JosePaen/proyecto-electrico-vivienda-unifamiliar/xlsx/PE-VU_Proyecto_Electrico_Vivienda_Unifamiliar.xlsx

Sheet: Grado Electrificacion
Cómputo de Superficies
Ambiente / Local | Tipo de superficie | Largo (m) | Ancho (m) | Sup. Real (m2) | Coeficiente | Sup. Computable (m2)
Dormitorio | Cubierta |  |  | 23.49 | 1.00 | 23.49
Baño principal | Cubierta |  |  | 6.52 | 1.00 | 6.52 | Sup. Total | 114.325
Estar | Cubierta |  |  | 10.48 | 1.00 | 10.48
Comedor | Cubierta |  |  | 19.30 | 1.00 | 19.30
Cocina | Cubierta |  |  | 7.31 | 1.00 | 7.31
Lavadero | Cubierta |  |  | 2.63 | 1.00 | 2.63
Baño servicio / lav. | Cubierta |  |  | 2.63 | 1.00 | 2.63
Tender | Semicubierta |  |  | 3.33 | 0.50 | 1.67
Cochera | Semicubierta |  |  | 36.41 | 0.50 | 18.20
Quincho | Semicubierta |  |  | 44.19 | 0.50 | 22.09
Total |  |  |  | 156.29 |  | 114.32
Parámetro | Valor Obtenido
Sup. Cubierta | 72.36
Sup. Semicubierta | 41.96
Superficie total (m2) | 114.32
Grado de Electrificación | Medio
Cantidad Mínima de Circuitos | 3
Variantes | a): 2 IUG + 1 TUG b): 1 IUG + 2 TUG

Sheet: Circuitos
Agrupamiento de bocas y definición de circuitos
Indicador | Valor |  | Fase | Potencia Equilibrada (VA) | Potencia Asignada (VA) | Distribución (%) | Desbalance de Fase (%) | ,
Potencia total instalada (VA) | 25930.00 |  | R | 8214.33 | 8147.33 | 0.31 | 0.82% | IDEAL
Demanda prevista máxima prevista (DPMS) -VA- | 24643.00 |  | S | 8214.33 | 8433.33 | 0.33 | -2.67% | IDEAL
Fase más cargada | S |  | T | 8214.33 | 8062.33 | 0.31 | 1.85% | IDEAL
Fase menos cargada | T
Desbalance | 4.52% | ✔ Cumple recomendación AEA (<10%)
Estado | IDEAL
Diferencia (VA) | 371.00
Circuito | Destino / Ambiente | Uso | Categoría | Sigla AEA | Cant. Bocas | Potencia Unitaria (VA) | Potencia Total (VA) | Factor Simultaneidad (Fs) | Demanda Simultánea (VA) | Fase | Tablero Destino
C1 | Dormitorio, baño, pasillo | Iluminación | Uso General | IUG | 13 | 60 | 780 | 0.8 | 624 | R | 1
C2 | Cochera, acceso | Iluminación | Uso General | IUG | 5 | 60 | 300 | 0.8 | 240 | T | 1
C3 | Cocina, comedor, estar | Iluminación | Uso General | IUG | 10 | 150 | 1500 | 0.66 | 990 | R | 1
C4 | Lavadero, baño 2, tender, quincho | Iluminación | Uso General | IUG | 11 | 150 | 1650 | 0.66 | 1089 | T | 1
C5 | Dormitorio, baño, pasillo | Tomacorrientes | Uso General | TUG | 7 | 2200 | 2200 | 1 | 2200 | S | 1
C6 | Cocina, comedor, estar | Tomacorrientes | Uso General | TUG | 7 | 2200 | 2200 | 1 | 2200 | T | 1
C7 | Lavadero, baño 2, tender, quincho | Tomacorrientes | Uso General | TUG | 4 | 2200 | 2200 | 1 | 2200 | T | 1
C8 | Motor portón | Específico | Otros | OCE | 2 | 600 | 600 | 1 | 600 | S | 1
C9 | Bomba de agua (1HP) | Específico | Otros | OCE | 1 | 1100 | 1100 | 1 | 1100 | S | 1
C10 | Cocina + Horno | Específico | Otros | OCE | 1 | 7000 | 7000 | 1 | 7000 | RST | 1
C11 | Termotanque | Específico | Otros | OCE | 1 | 2000 | 2000 | 1 | 2000 | R | 1
C12 | AA (Estar) | Específico | Otros | OCE | 1 | 2200 | 2200 | 1 | 2200 | R | 1
C13 | AA (Dormitorio) | Específico | Otros | OCE | 1 | 2200 | 2200 | 1 | 2200 | S | 1
Total |  |  |  |  | 64 |  | 25930 |  | 24643

Sheet: Coductores
Circuito | Ambiente | Uso | Tipo | Abrev. | Potencia Demandada (VA) | Fase | Tensión (V) | Corriente de Proyecto Ib (A) | Longitud ida (m) | N° Conductores Activos | Método de instalación | Metodo de instalación (Descripción) | Material conductor | Tipo de aislación | Resistividad (ρ) | N° de circuitos agrupados | Factor de agrupamiento | Temperatura (°C) | Factor de temperatura | Iz Requerida Corregida (A) | Sección mínima por Iz (mm²) | Sección Conductor (mm²) | Iz real corregida (A) | Conductor PE (mm²) | Caida de tensión (V) | Caída de tensión (%) | Verificación (<3%) | Calibre Termomagnética In (A) | Verificación | Designación de Cables | N° conductores canalización | Diámetro Cañería | Área ocupada (mm²)
C1 | Dormitorio, baño, pasillo | Iluminación | Uso General | IUG | 780 | R | 220 | 3.55 | 55 | 2 | B1 | Conductores aislados en cañería sobre pared | Cobre | PVC | 0.017241 | 1 | 1 | 40 | 0.87 | 4.60 | 1.5 | 1.5 | 13.05 | 1.5 | 4.48 | 2.04% | Cumple | 10 | ✅ CUMPLE | 2 x 1,5 mm² + PE 1,5 mm² | 3.00 | Caño PVC Ø20 mm
C2 | Cochera, acceso | Iluminación | Uso General | IUG | 300 | T | 220 | 1.36 | 20 | 2 | B1 | Conductores aislados en cañería sobre pared | Cobre | PVC | 0.017241 | 1 | 1 | 40 | 0.87 | 2.30 | 1.5 | 1.5 | 13.05 | 1.5 | 0.63 | 0.28% | Cumple | 10 | ✅ CUMPLE | 2 x 1,5 mm² + PE 1,5 mm² | 3.00 | Caño PVC Ø20 mm
C3 | Cocina, comedor, estar | Iluminación | Uso General | IUG | 1500 | R | 220 | 6.82 | 35 | 2 | B1 | Conductores aislados en cañería sobre pared | Cobre | PVC | 0.017241 | 1 | 1 | 40 | 0.87 | 11.49 | 1.5 | 1.5 | 13.05 | 1.5 | 5.49 | 2.49% | Cumple | 10 | ✅ CUMPLE | 2 x 1,5 mm² + PE 1,5 mm² | 3.00 | Caño PVC Ø20 mm
C4 | Lavadero, baño 2, tender, quincho | Iluminación | Uso General | IUG | 1650 | T | 220 | 7.50 | 27 | 2 | B1 | Conductores aislados en cañería sobre pared | Cobre | PVC | 0.017241 | 1 | 1 | 40 | 0.87 | 11.49 | 1.5 | 1.5 | 13.05 | 1.5 | 4.66 | 2.12% | Cumple | 10 | ✅ CUMPLE | 2 x 1,5 mm² + PE 1,5 mm² | 3.00 | Caño PVC Ø20 mm
C5 | Dormitorio, baño, pasillo | Tomacorrientes | Uso General | TUG | 2200 | S | 220 | 10.00 | 15 | 2 | B1 | Conductores aislados en cañería sobre pared | Cobre | PVC | 0.017241 | 1 | 1 | 40 | 0.87 | 11.49 | 1.5 | 2.5 | 18.27 | 2.5 | 2.07 | 0.94% | Cumple | 16 | ✅ CUMPLE | 2 x 2,5 mm² + PE 2,5 mm² | 3.00 | Caño PVC Ø20 mm
C6 | Cocina, comedor, estar | Tomacorrientes | Uso General | TUG | 2200 | T | 220 | 10.00 | 22 | 2 | B1 | Conductores aislados en cañería sobre pared | Cobre | PVC | 0.017241 | 1 | 1 | 40 | 0.87 | 11.49 | 1.5 | 2.5 | 18.27 | 2.5 | 3.03 | 1.38% | Cumple | 16 | ✅ CUMPLE | 2 x 2,5 mm² + PE 2,5 mm² | 3.00 | Caño PVC Ø20 mm
C7 | Lavadero, baño 2, tender, quincho | Tomacorrientes | Uso General | TUG | 2200 | T | 220 | 10.00 | 10 | 2 | B1 | Conductores aislados en cañería sobre pared | Cobre | PVC | 0.017241 | 1 | 1 | 40 | 0.87 | 11.49 | 1.5 | 2.5 | 18.27 | 2.5 | 1.38 | 0.63% | Cumple | 16 | ✅ CUMPLE | 2 x 2,5 mm² + PE 2,5 mm² | 3.00 | Caño PVC Ø20 mm
C8 | Motor portón | Específico | Otros | OCE | 600 | S | 220 | 2.73 | 56 | 2 | B1 | Conductores aislados en cañería sobre pared | Cobre | PVC | 0.017241 | 1 | 1 | 40 | 0.87 | 4.60 | 1.5 | 2.5 | 18.27 | 2.5 | 2.11 | 0.96% | Cumple | 16 | ✅ CUMPLE | 2 x 2,5 mm² + PE 2,5 mm² | 3.00 | Caño PVC Ø20 mm
C9 | Bomba de agua (1HP) | Específico | Otros | OCE | 1100 | S | 220 | 5.00 | 22 | 2 | B1 | Conductores aislados en cañería sobre pared | Cobre | PVC | 0.017241 | 1 | 1 | 40 | 0.87 | 6.90 | 1.5 | 2.5 | 18.27 | 2.5 | 1.52 | 0.69% | Cumple | 16 | ✅ CUMPLE | 2 x 2,5 mm² + PE 2,5 mm² | 3.00 | Caño PVC Ø20 mm
C10 | Cocina + Horno | Específico | Otros | OCE | 7000 | RST | 380 | 10.64 | 25.00 | 3 | B1 | Conductores aislados en cañería sobre pared | Cobre | PVC | 0.017241 | 1 | 1 | 40 | 0.87 | 18.39 | 4 | 4 | 21.75 | 4 | 1.98 | 0.52% | Cumple | 20 | ✅ CUMPLE | 4 x 4 mm² + PE 4 mm² | 5.00 | Caño PVC Ø25 mm
C11 | Termotanque | Específico | Otros | OCE | 2000 | R | 220 | 9.09 | 26.00 | 2 | B1 | Conductores aislados en cañería sobre pared | Cobre | PVC | 0.017241 | 1 | 1 | 40 | 0.87 | 11.49 | 1.5 | 4 | 24.36 | 4 | 2.04 | 0.93% | Cumple | 20 | ✅ CUMPLE | 2 x 4 mm² + PE 4 mm² | 3.00 | Caño PVC Ø20 mm
C12 | AA (Estar) | Específico | Otros | OCE | 2200 | R | 220 | 10.00 | 22.00 | 2 | B1 | Conductores aislados en cañería sobre pared | Cobre | PVC | 0.017241 | 1 | 1 | 40 | 0.87 | 11.49 | 1.5 | 4 | 24.36 | 4 | 1.90 | 0.86% | Cumple | 20 | ✅ CUMPLE | 2 x 4 mm² + PE 4 mm² | 3.00 | Caño PVC Ø20 mm
C13 | AA (Dormitorio) | Específico | Otros | OCE | 2200 | S | 220 | 10.00 | 19.00 | 2 | B1 | Conductores aislados en cañería sobre pared | Cobre | PVC | 0.017241 | 1 | 1 | 40 | 0.87 | 11.49 | 1.5 | 4 | 24.36 | 4 | 1.64 | 0.74% | Cumple | 20 | ✅ CUMPLE | 2 x 4 mm² + PE 4 mm² | 3.00 | Caño PVC Ø20 mm
Total |  |  |  |  | 25930

Sheet: General
MEMORIA DE CÁLCULO: ALIMENTADOR SECCIONAL (TP a TS1)
Parámetro | Valor / Especificación | Parámetro | Valor / Especificación
Línea | Alimentador TG -> TS1 | Línea | Alimentador TG -> TS1
Origen | Tablero Principal (TP) | Origen | Tablero Principal (TP)
Destino | Tablero Seccional (TS1) | Destino | Tablero Seccional (TS1)
Sistema | 3F + N + PE | Sistema | 3F + N + PE
Tensión Nominal (V) | 380 | Tensión Nominal (V) | 380
Potencia Total Conectada / Instalada (VA) | 25930.00 | Potencia Total Conectada / Instalada (VA) | 25930
Demanda de Potencia (VA) | 24643.00 | Demanda de Potencia (VA) | 24643
Grado de Electrificación Resultante | Superior (> 6 circuitos y > 11 kVA) | Grado de Electrificación Resultante | Superior (> 6 circuitos y > 11 kVA)
Corriente de Proyecto Ib (A) | 37.44 | Corriente de Proyecto Ib (A) | 37.44116496
Longitud L (m) | 20 | Longitud L (m) | 20
Método Instalación | B1 | Método Instalación | B1
Tipo Cable | IRAM NM 247-3 | Tipo Cable | IRAM NM 247-3
N° Conductores Activos | 3 | N° Conductores Activos | 3
Factor Temp / Agrup | 0.87 | Factor Temp / Agrup | 0.87
Iz Requerida Corregida (A) | 45.98 | Iz Requerida Corregida (A) | 45.97701149
Sección Conductor (mm²) | 16 | Sección Conductor (mm²) | 16
Conductor PE (mm²) | 16 | Conductor PE (mm²) | 16
Caída Tensión (V) | 1.40 | Caída Tensión (V) | 1.397598562
Caída Tensión (%) | 0.37% | Caída Tensión (%) | 0.003677890954
Verificación Caída | ☑ CUMPLE (≤1%) | Verificación Caída | ☑ CUMPLE (≤1%)
Iz Real Corregida (A) | 51.33 | Iz Real Corregida (A) | 51.33
Calibre Termomagnética In (A) | 50 | Calibre Termomagnética In (A) | 63 | Se modifica por selectividad
Protección Diferencial | 4 x 63 A / 300 mA (Selectivo) | Protección Diferencial | 4 x 63 A / 300 mA (Selectivo)
Diámetro Cañería | Caño PVC Ø40 mm | Diámetro Cañería | Caño PVC Ø40 mm
Designación Conductores | 4 x 16 mm² + PE 16 mm² | Designación Conductores | 4 x 16 mm² + PE 16 mm²

Sheet: Resumen
N° Cto | Fase | Destino / Carga | Tipo AEA | Bocas | Potencia (VA) | Ib (A) | Conductor | Cañería | ΔV (%) | Protección (PIA) | Diferencial Asociado | Módulos DIN | Concepto | Módulos DIN
C1 | R | Dormitorio, baño, pasillo | IUG | 13 | 624 | 3.55 | 2 x 1,5 mm² + PE 1,5 mm² | Caño PVC Ø20 mm | 2.04% | Curva C 10A (2P) | ID-R | 2 | Interruptor General de Cabecera (IGA) | 4
C2 | T | Cochera, acceso | IUG | 5 | 240 | 1.36 | 2 x 1,5 mm² + PE 1,5 mm² | Caño PVC Ø20 mm | 0.28% | Curva C 10A (2P) | ID-T | 2 | Protecciones Diferenciales (ID) | 10
C3 | R | Cocina, comedor, estar | IUG | 10 | 990 | 6.82 | 2 x 1,5 mm² + PE 1,5 mm² | Caño PVC Ø20 mm | 2.49% | Curva C 10A (2P) | ID-R | 2 | Térmicas de Circuitos Terminales (PIA) | 28
C4 | T | Lavadero, baño 2, tender, quincho | IUG | 11 | 1089 | 7.50 | 2 x 1,5 mm² + PE 1,5 mm² | Caño PVC Ø20 mm | 2.12% | Curva C 10A (2P) | ID-T | 2 | Descargador de Sobretensiones (DPS) | 4
C5 | S | Dormitorio, baño, pasillo | TUG | 7 | 2200 | 10.00 | 2 x 2,5 mm² + PE 2,5 mm² | Caño PVC Ø20 mm | 0.94% | Curva C 16A (2P) | ID-S | 2 | Total Módulos Ocupados | 46
C6 | T | Cocina, comedor, estar | TUG | 7 | 2200 | 10.00 | 2 x 2,5 mm² + PE 2,5 mm² | Caño PVC Ø20 mm | 1.38% | Curva C 16A (2P) | ID-T | 2 | Reserva Mínima Obligatoria AEA (20%) | 10
C7 | T | Lavadero, baño 2, tender, quincho | TUG | 4 | 2200 | 10.00 | 2 x 2,5 mm² + PE 2,5 mm² | Caño PVC Ø20 mm | 0.63% | Curva C 16A (2P) | ID-T | 2 | Capacidad Mínima Reglamentaria | 56
C8 | S | Motor portón | OCE | 2 | 600 | 2.73 | 2 x 2,5 mm² + PE 2,5 mm² | Caño PVC Ø20 mm | 0.96% | Curva C 16A (2P) | ID-S | 2 | Gabinete Adoptado | 60 | ✅ CUMPLE RESERVA (≥20%)
C9 | S | Bomba de agua (1HP) | OCE | 1 | 1100 | 5.00 | 2 x 2,5 mm² + PE 2,5 mm² | Caño PVC Ø20 mm | 0.69% | Curva C 16A (2P) | ID-S | 2
C10 | RST | Cocina + Horno | OCE | 1 | 7000 | 10.64 | 4 x 4 mm² + PE 4 mm² | Caño PVC Ø25 mm | 0.52% | Curva C 20A (4P) | ID-4 (4P) | 4
C11 | R | Termotanque | OCE | 1 | 2000 | 9.09 | 2 x 4 mm² + PE 4 mm² | Caño PVC Ø20 mm | 0.93% | Curva C 20A (2P) | ID-R | 2
C12 | R | AA (Estar) | OCE | 1 | 2200 | 10.00 | 2 x 4 mm² + PE 4 mm² | Caño PVC Ø20 mm | 0.86% | Curva C 20A (2P) | ID-R | 2 | Fabricante / Línea | Montaje | Configuración | Alto (cm) | Ancho (cm) | Prof. (cm)
C13 | S | AA (Dormitorio) | OCE | 1 | 2200 | 10.00 | 2 x 4 mm² + PE 4 mm² | Caño PVC Ø20 mm | 0.74% | Curva C 20A (2P) | ID-S | 2 | Schneider (Mini Pragma / Resi9) | Embutir | 4 filas x 15 mód. | 75 | 35 | 10.5
 |  |  |  |  |  |  |  |  |  |  |  |  | Genrod (Q-Energy) | Embutir | 4 filas x 15 mód. | 68 | 42 | 11
 |  |  |  |  |  |  |  |  |  |  |  |  | Conextube (Vulcano / Platino) | Embutir | 5 filas x 12 mód. | 82 | 31 | 11.5
 |  |  |  |  |  |  |  | 60
