JosePaen/proyecto-electrico-vivienda-unifamiliar/(list of files, cad)

Other CAD files:
dwg/PE-VU_Proyecto_Electrico_Vivienda_Unifamiliar.dwg
