JosePaen/proyecto-electrico-vivienda-unifamiliar/pdf/PE-VU_Proyecto_Electrico_Vivienda_Unifamiliar.pdf

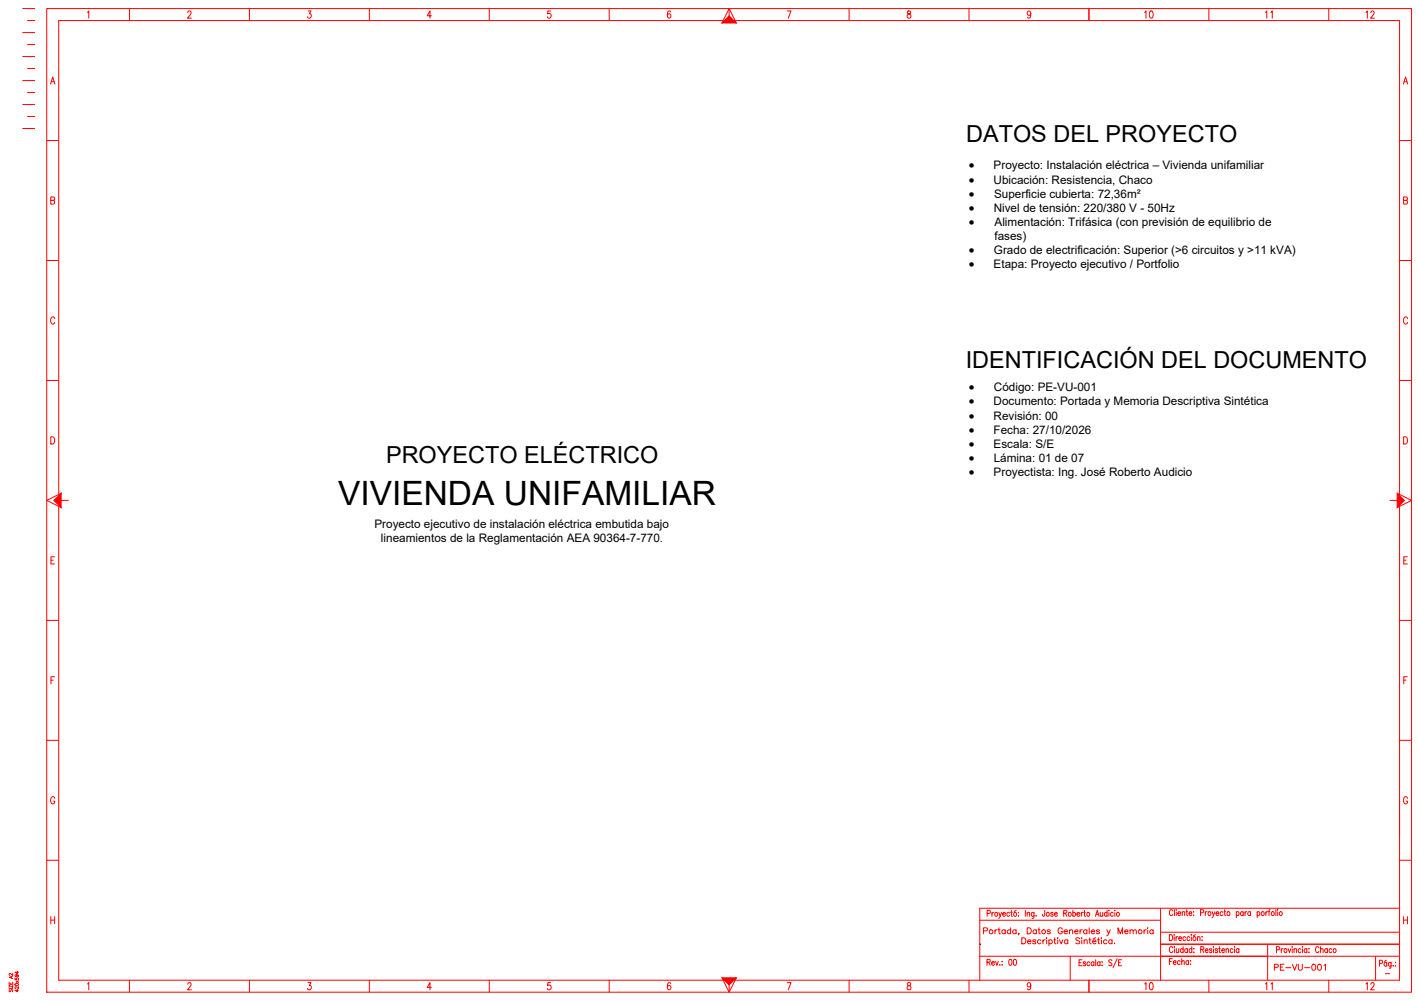
[picture p1: page 1]
PROYECTO ELÉCTRICO VIVIENDA UNIFAMILIAR

DATOS DEL PROYECTO

· Proyecto: Instalación eléctrica – Vivienda unifamiliar
· Ubicación: Resistencia, Chaco
· Superficie cubierta: 72,36m²
· Nivel de tensión: 220/380 V - 50Hz
· Alimentación: Trifásica (con previsión de equilibrio de
fases)
· Grado de electrificación: Superior (>6 circuitos y >11 kVA)
· Etapa: Proyecto ejecutivo / Portfolio

IDENTIFICACIÓN DEL DOCUMENTO

· Código: PE-VU-001
· Documento: Portada y Memoria Descriptiva Sintética
· Revisión: 00
· Fecha: 27/10/2026
· Escala: S/E
· Lámina: 01 de 07
· Proyectista: Ing. José Roberto Audicio

Proyecto ejecutivo de instalación eléctrica embutida bajo
lineamientos de la Reglamentación AEA 90364-7-770.

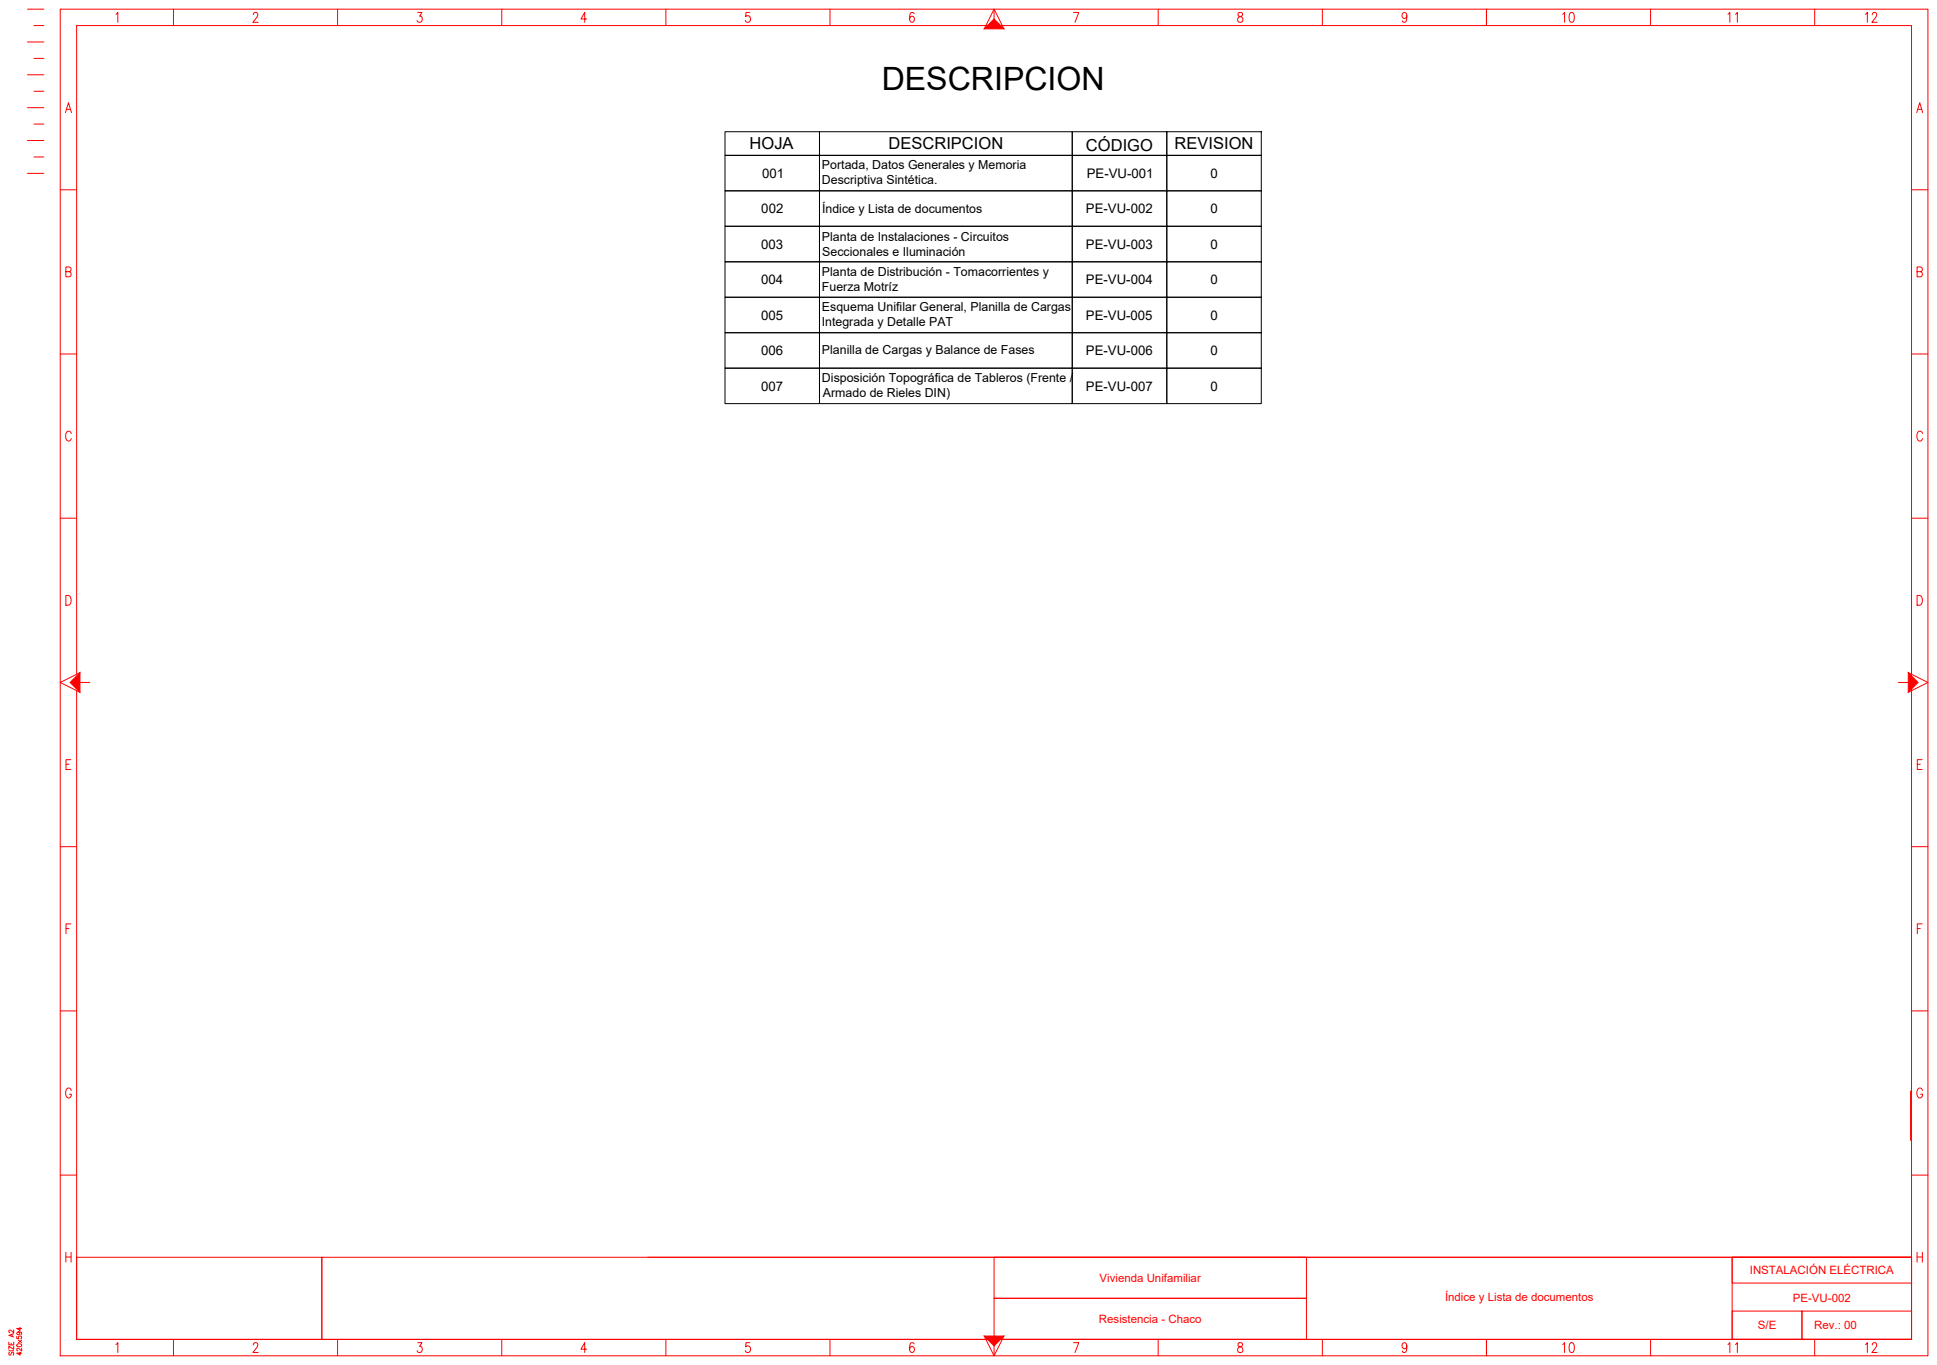
[picture p2: page 2]
Vivienda Unifamiliar; Resistencia - Chaco; Rev.: 00; INSTALACIÓN ELÉCTRICA

HOJA | DESCRIPCION | CÓDIGO | REVISION

001 | Portada, Datos Generales y Memoria Descriptiva Sintética. | PE-VU-001 | 0

002 | Índice y Lista de documentos | PE-VU-002 | 0

Planta de Instalaciones - Circuitos Seccionales e Iluminación 003 | PE-VU-003 | 0

Planta de Distribución - Tomacorrientes y Fuerza Motríz 004 | PE-VU-004 | 0

Esquema Unifilar General, Planilla de Cargas Integrada y Detalle PAT 005 | PE-VU-005 | 0

006 | Planilla de Cargas y Balance de Fases | PE-VU-006 | 0

Disposición Topográfica de Tableros (Frente / Armado de Rieles DIN) 007 | PE-VU-007 | 0

Índice y Lista de documentos

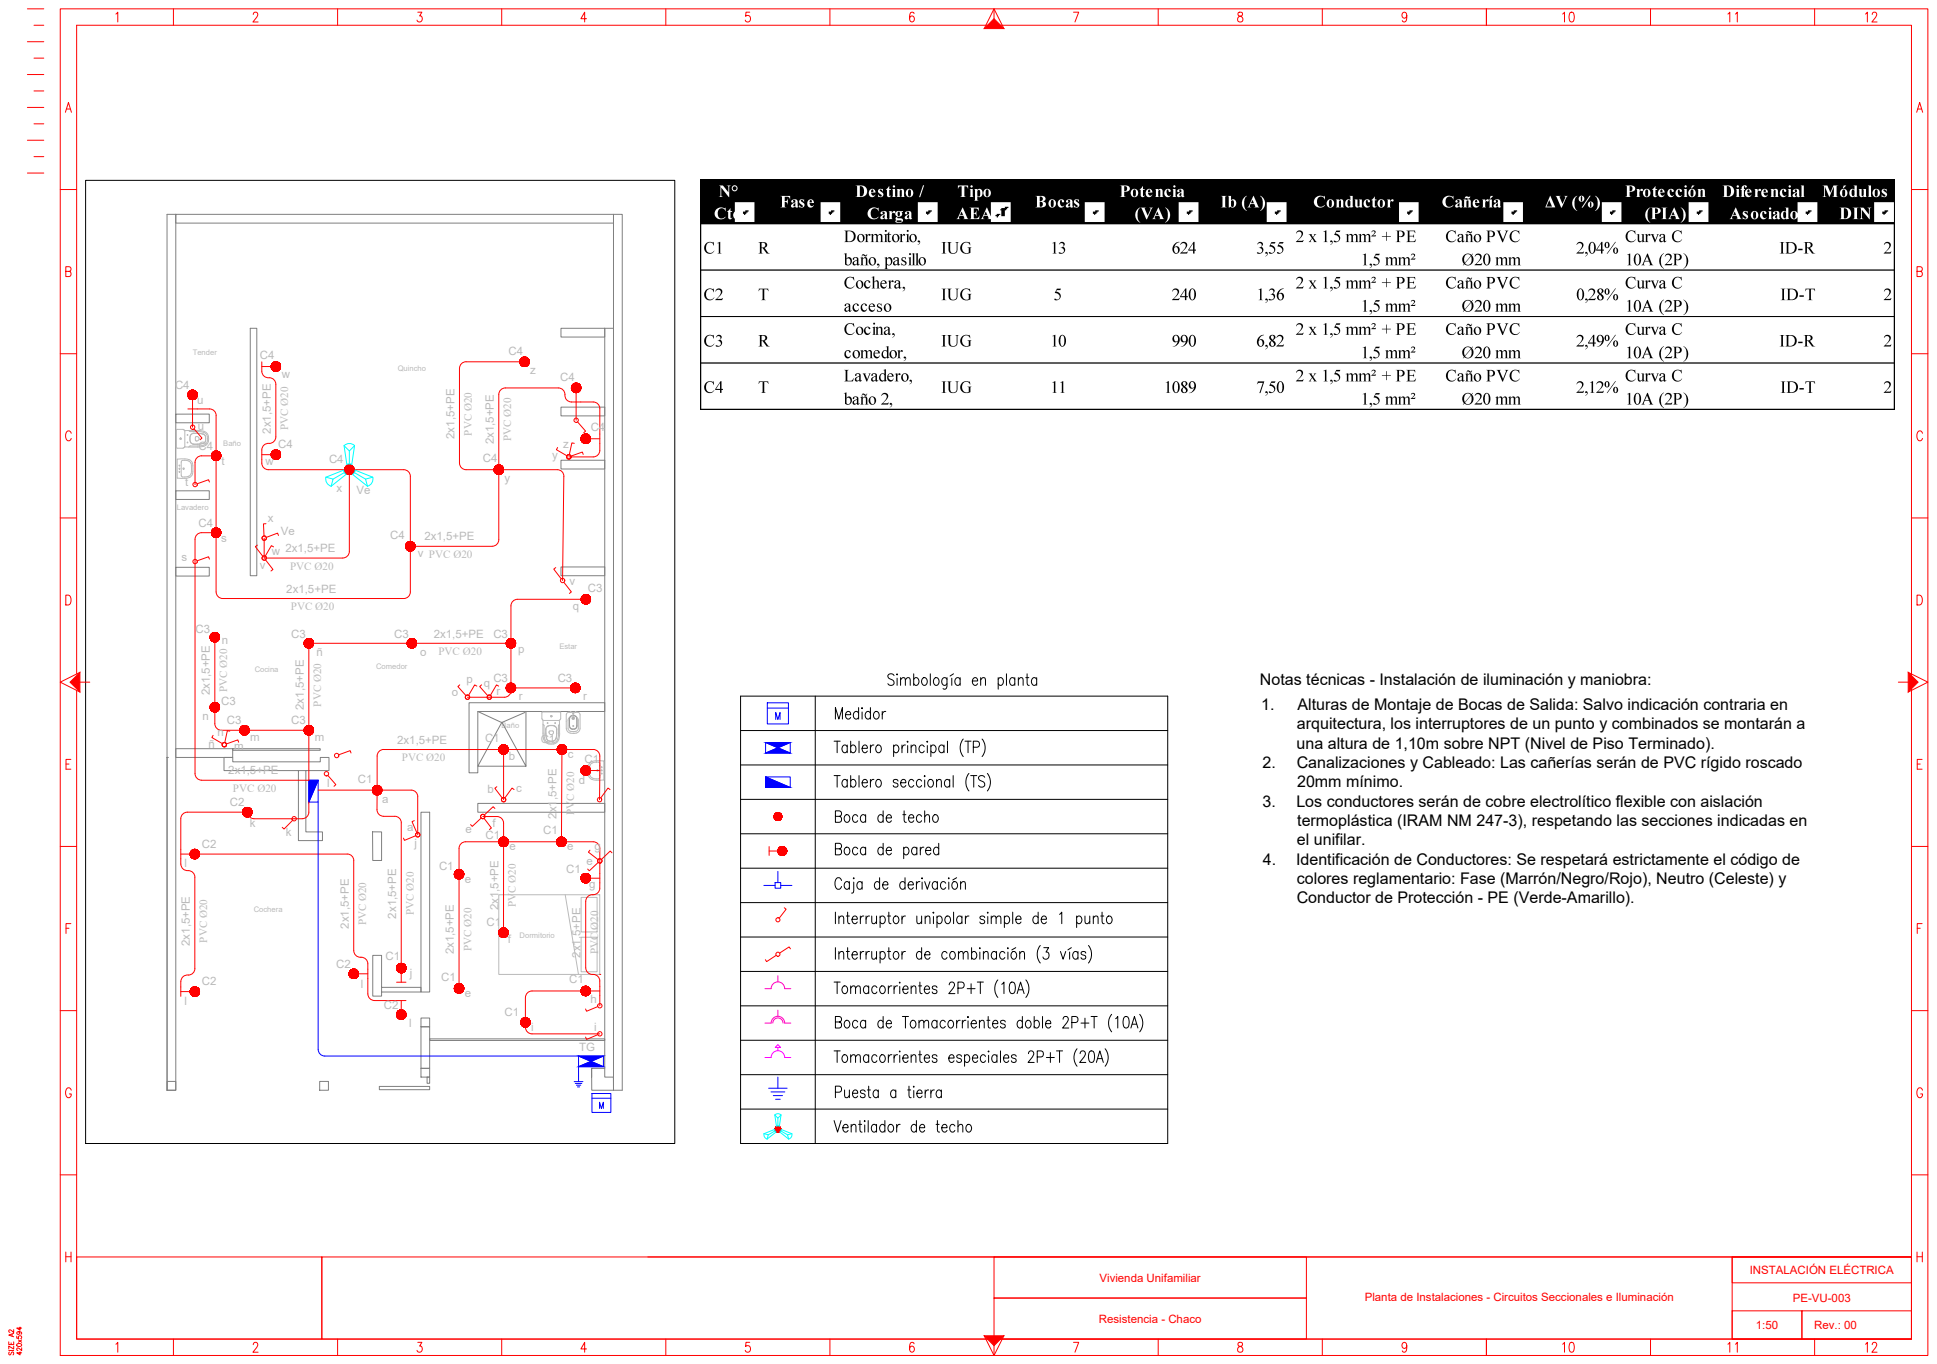
[picture p3: page 3]
ce eee; PVC Ø20 2x1,5+PE; 2x1,5+PE PVC Ø20 PVC Ø20; 2x1,5+PE PVC Ø20; 2x1,5+PE PVC Ø20 2x1,5+PE PVC Ø20 2x1,5+PE PVC Ø20 2x1,5+PE PVC Ø20; 2x1,5+PE PVC Ø20 2x1,5+PE PVC Ø20; PVC Ø20

Notas técnicas - Instalación de iluminación y maniobra:
1. Alturas de Montaje de Bocas de Salida: Salvo indicación contraria en
arquitectura, los interruptores de un punto y combinados se montarán a
una altura de 1,10m sobre NPT (Nivel de Piso Terminado).
2. Canalizaciones y Cableado: Las cañerías serán de PVC rígido roscado
20mm mínimo.
3. Los conductores serán de cobre electrolítico flexible con aislación
termoplástica (IRAM NM 247-3), respetando las secciones indicadas en
el unifilar.
4. Identificación de Conductores: Se respetará estrictamente el código de
colores reglamentario: Fase (Marrón/Negro/Rojo), Neutro (Celeste) y
Conductor de Protección - PE (Verde-Amarillo).

Planta de Instalaciones - Circuitos Seccionales e Iluminación

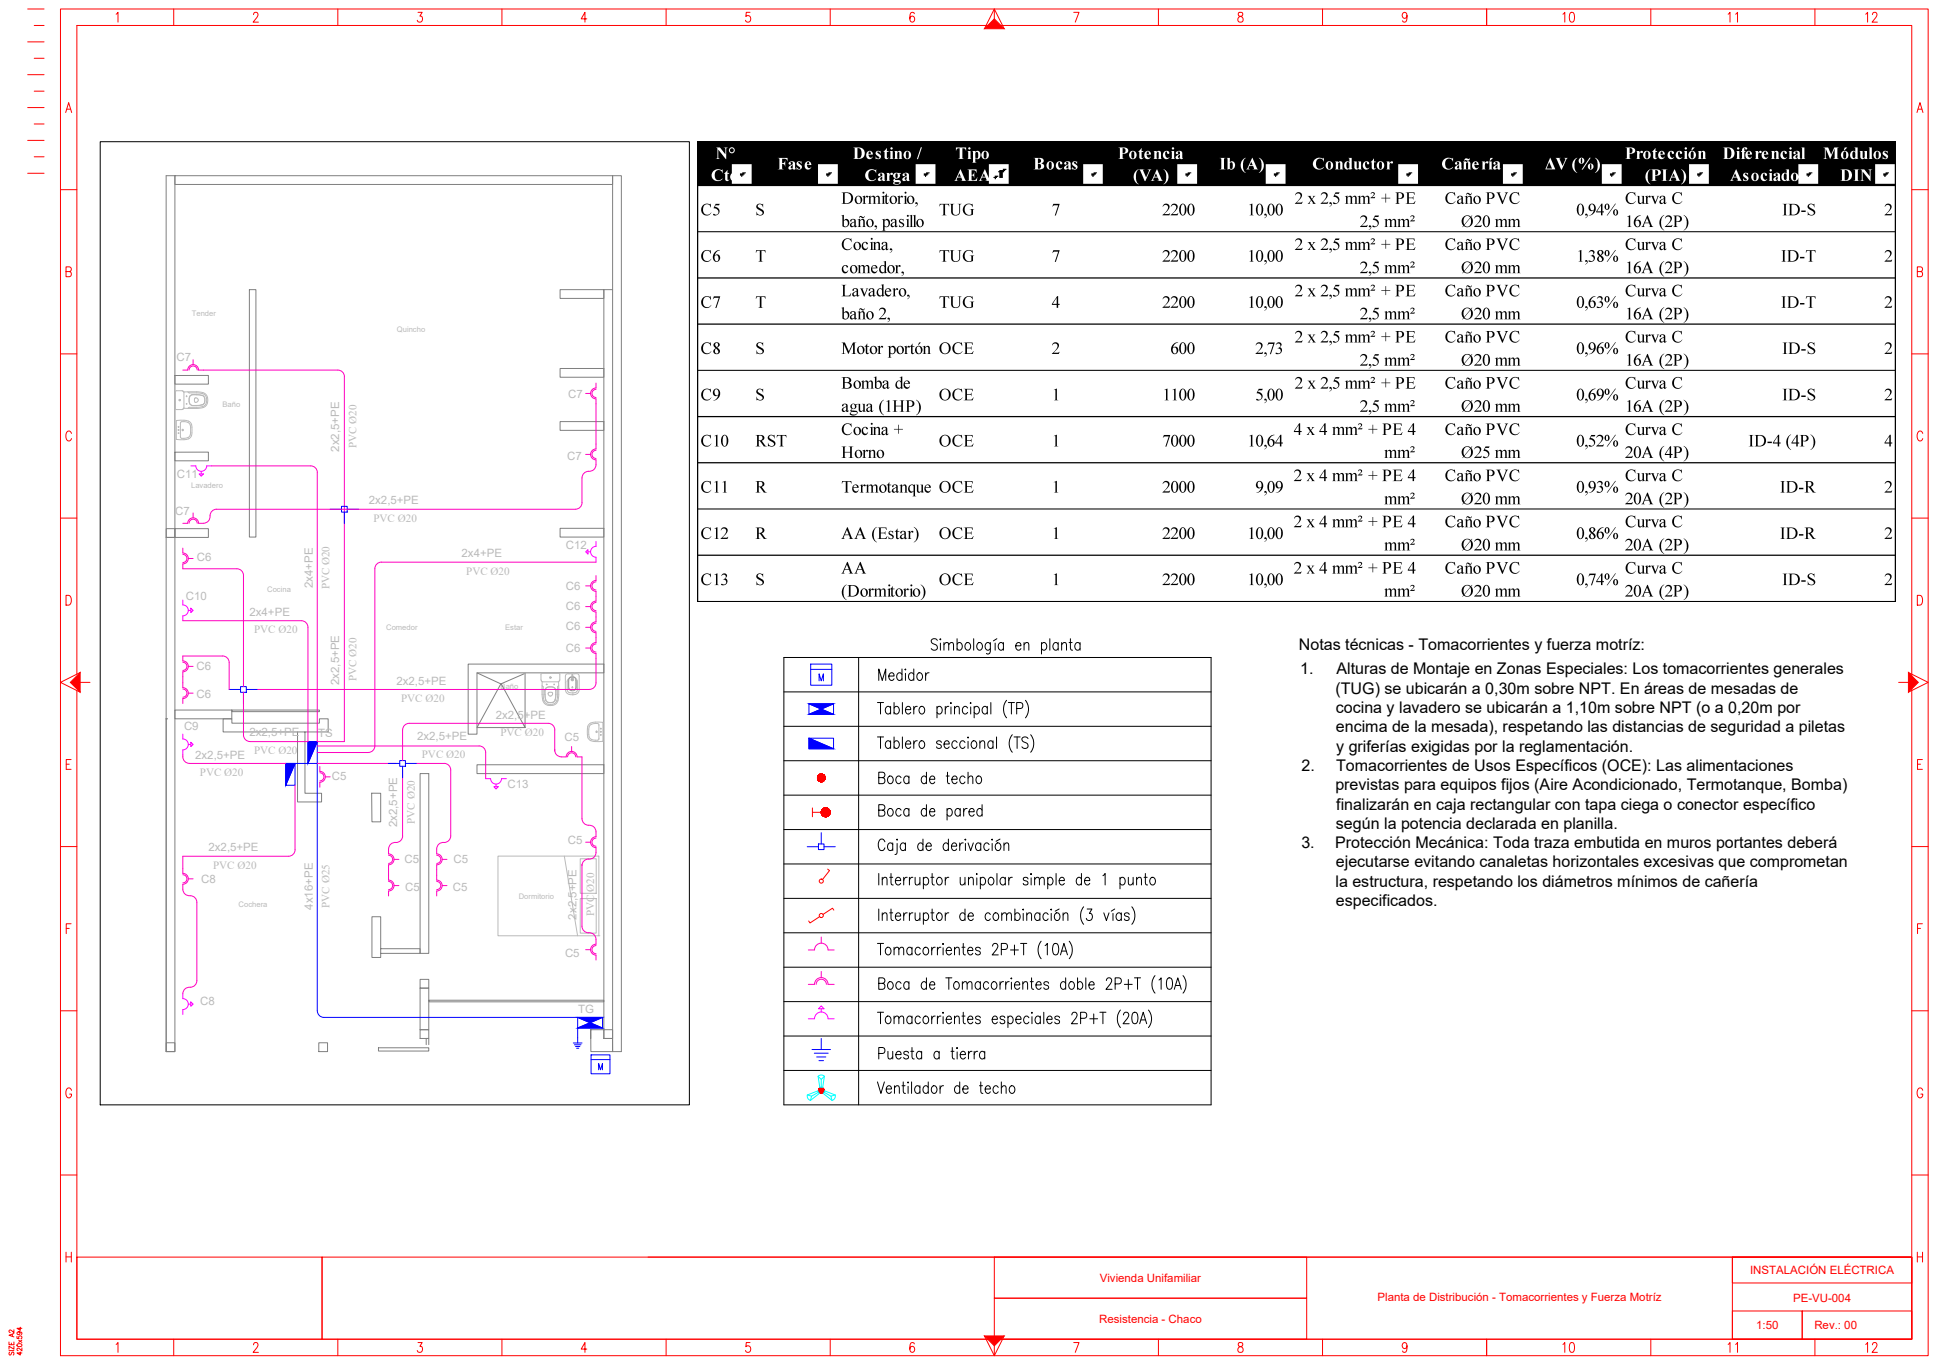
[picture p4: page 4]

Notas técnicas - Tomacorrientes y fuerza motríz:
1. Alturas de Montaje en Zonas Especiales: Los tomacorrientes generales
(TUG) se ubicarán a 0,30m sobre NPT. En áreas de mesadas de
cocina y lavadero se ubicarán a 1,10m sobre NPT (o a 0,20m por
encima de la mesada), respetando las distancias de seguridad a piletas
y griferías exigidas por la reglamentación.
2. Tomacorrientes de Usos Específicos (OCE): Las alimentaciones
previstas para equipos fijos (Aire Acondicionado, Termotanque, Bomba)
finalizarán en caja rectangular con tapa ciega o conector específico
según la potencia declarada en planilla.
3. Protección Mecánica: Toda traza embutida en muros portantes deberá
ejecutarse evitando canaletas horizontales excesivas que comprometan
la estructura, respetando los diámetros mínimos de cañería
especificados.

Planta de Distribución - Tomacorrientes y Fuerza Motríz

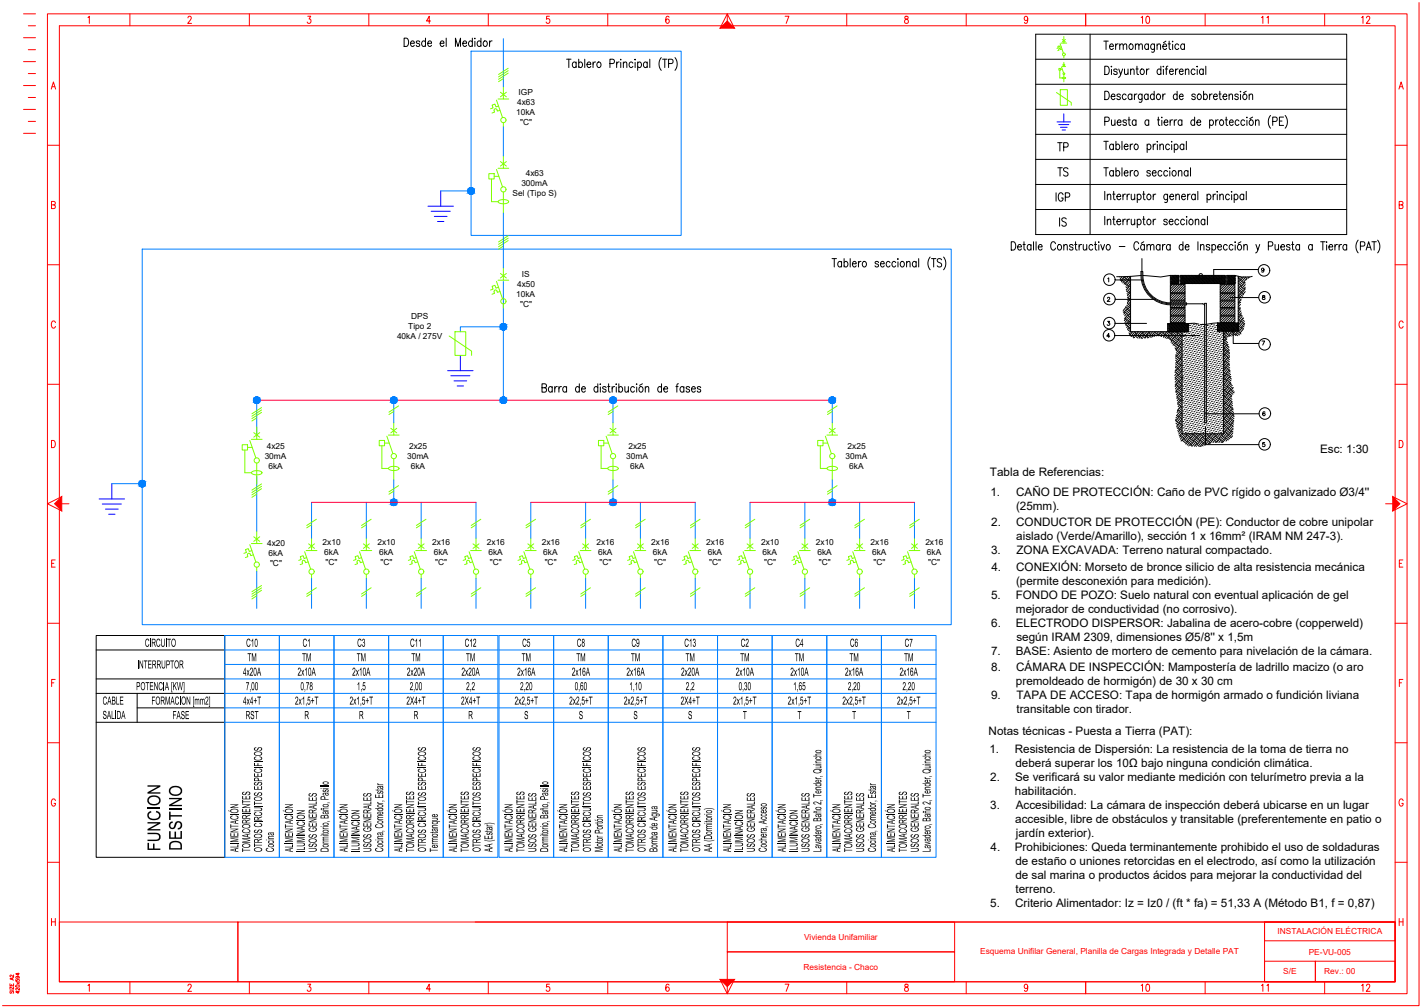
[picture p5: page 5]

DPS | 4x50 10kA "C"

Tabla de Referencias:
1. CAÑO DE PROTECCIÓN: Caño de PVC rígido o galvanizado Ø3/4''
2. CONDUCTOR DE PROTECCIÓN (PE): Conductor de cobre unipolar
aislado (Verde/Amarillo), sección 1 x 16mm² (IRAM NM 247-3).
3. ZONA EXCAVADA: Terreno natural compactado.
4. CONEXIÓN: Morseto de bronce silicio de alta resistencia mecánica
(permite desconexión para medición).
5. FONDO DE POZO: Suelo natural con eventual aplicación de gel
mejorador de conductividad (no corrosivo).
6. ELECTRODO DISPERSOR: Jabalina de acero-cobre (copperweld)
según IRAM 2309, dimensiones Ø5/8'' x 1,5m
7. BASE: Asiento de mortero de cemento para nivelación de la cámara.
8. CÁMARA DE INSPECCIÓN: Mampostería de ladrillo macizo (o aro
premoldeado de hormigón) de 30 x 30 cm
9. TAPA DE ACCESO: Tapa de hormigón armado o fundición liviana
transitable con tirador.

Notas técnicas - Puesta a Tierra (PAT):
1. Resistencia de Dispersión: La resistencia de la toma de tierra no
deberá superar los 10Ω bajo ninguna condición climática.
2. Se verificará su valor mediante medición con telurímetro previa a la
habilitación.
3. Accesibilidad: La cámara de inspección deberá ubicarse en un lugar
accesible, libre de obstáculos y transitable (preferentemente en patio o
jardín exterior).
4. Prohibiciones: Queda terminantemente prohibido el uso de soldaduras
de estaño o uniones retorcidas en el electrodo, así como la utilización
de sal marina o productos ácidos para mejorar la conductividad del
terreno.
5. Criterio Alimentador: Iz = Iz0 / (ft * fa) = 51,33 A (Método B1, f = 0,87)

Esquema Unifilar General, Planilla de Cargas Integrada y Detalle PAT

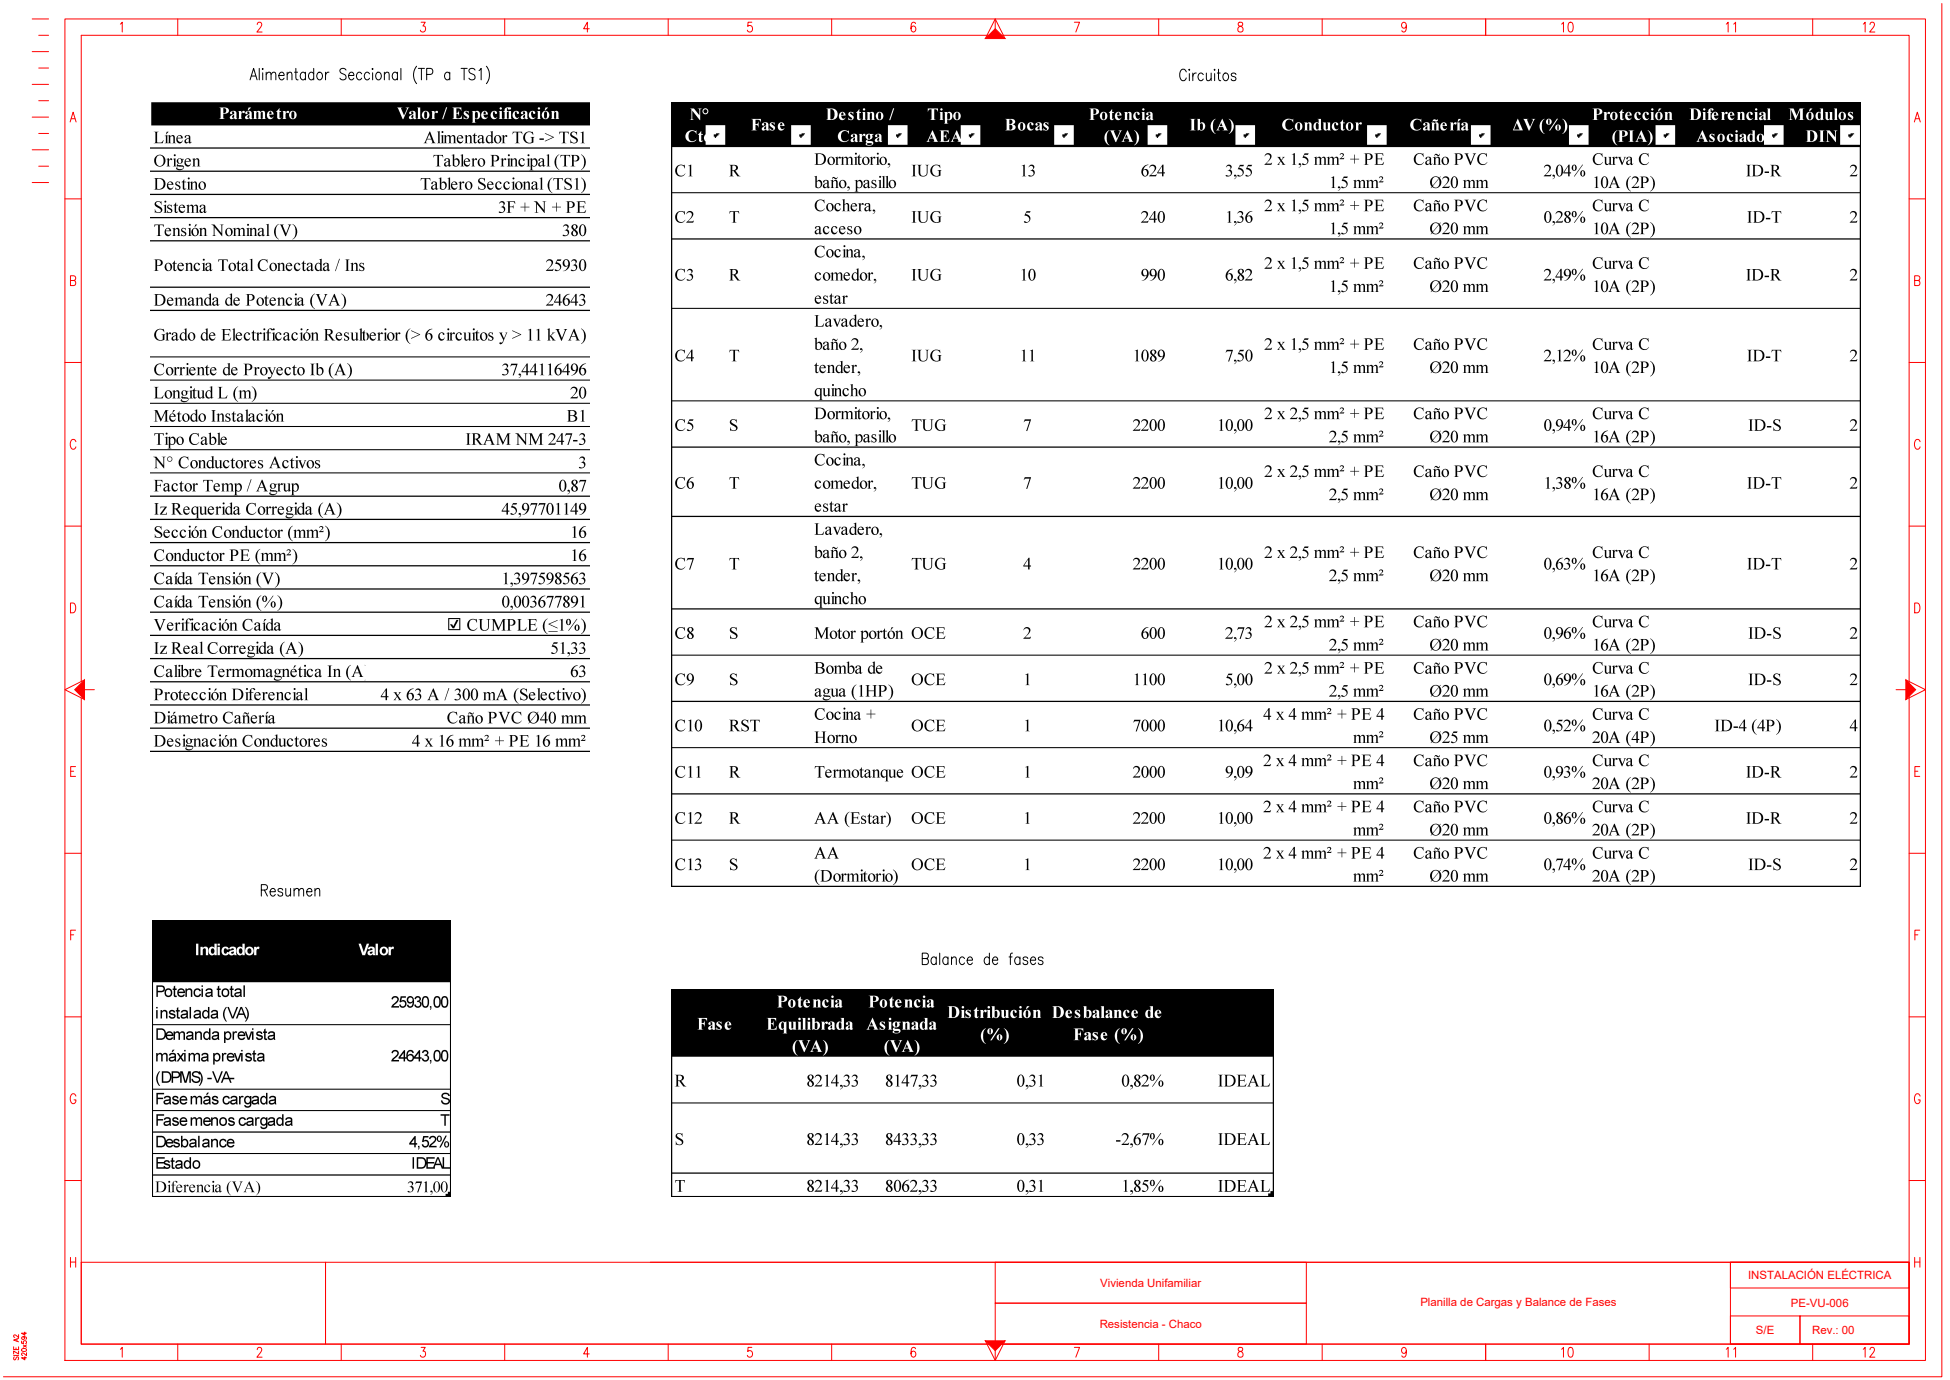
[picture p6: page 6]

Planilla de Cargas y Balance de Fases

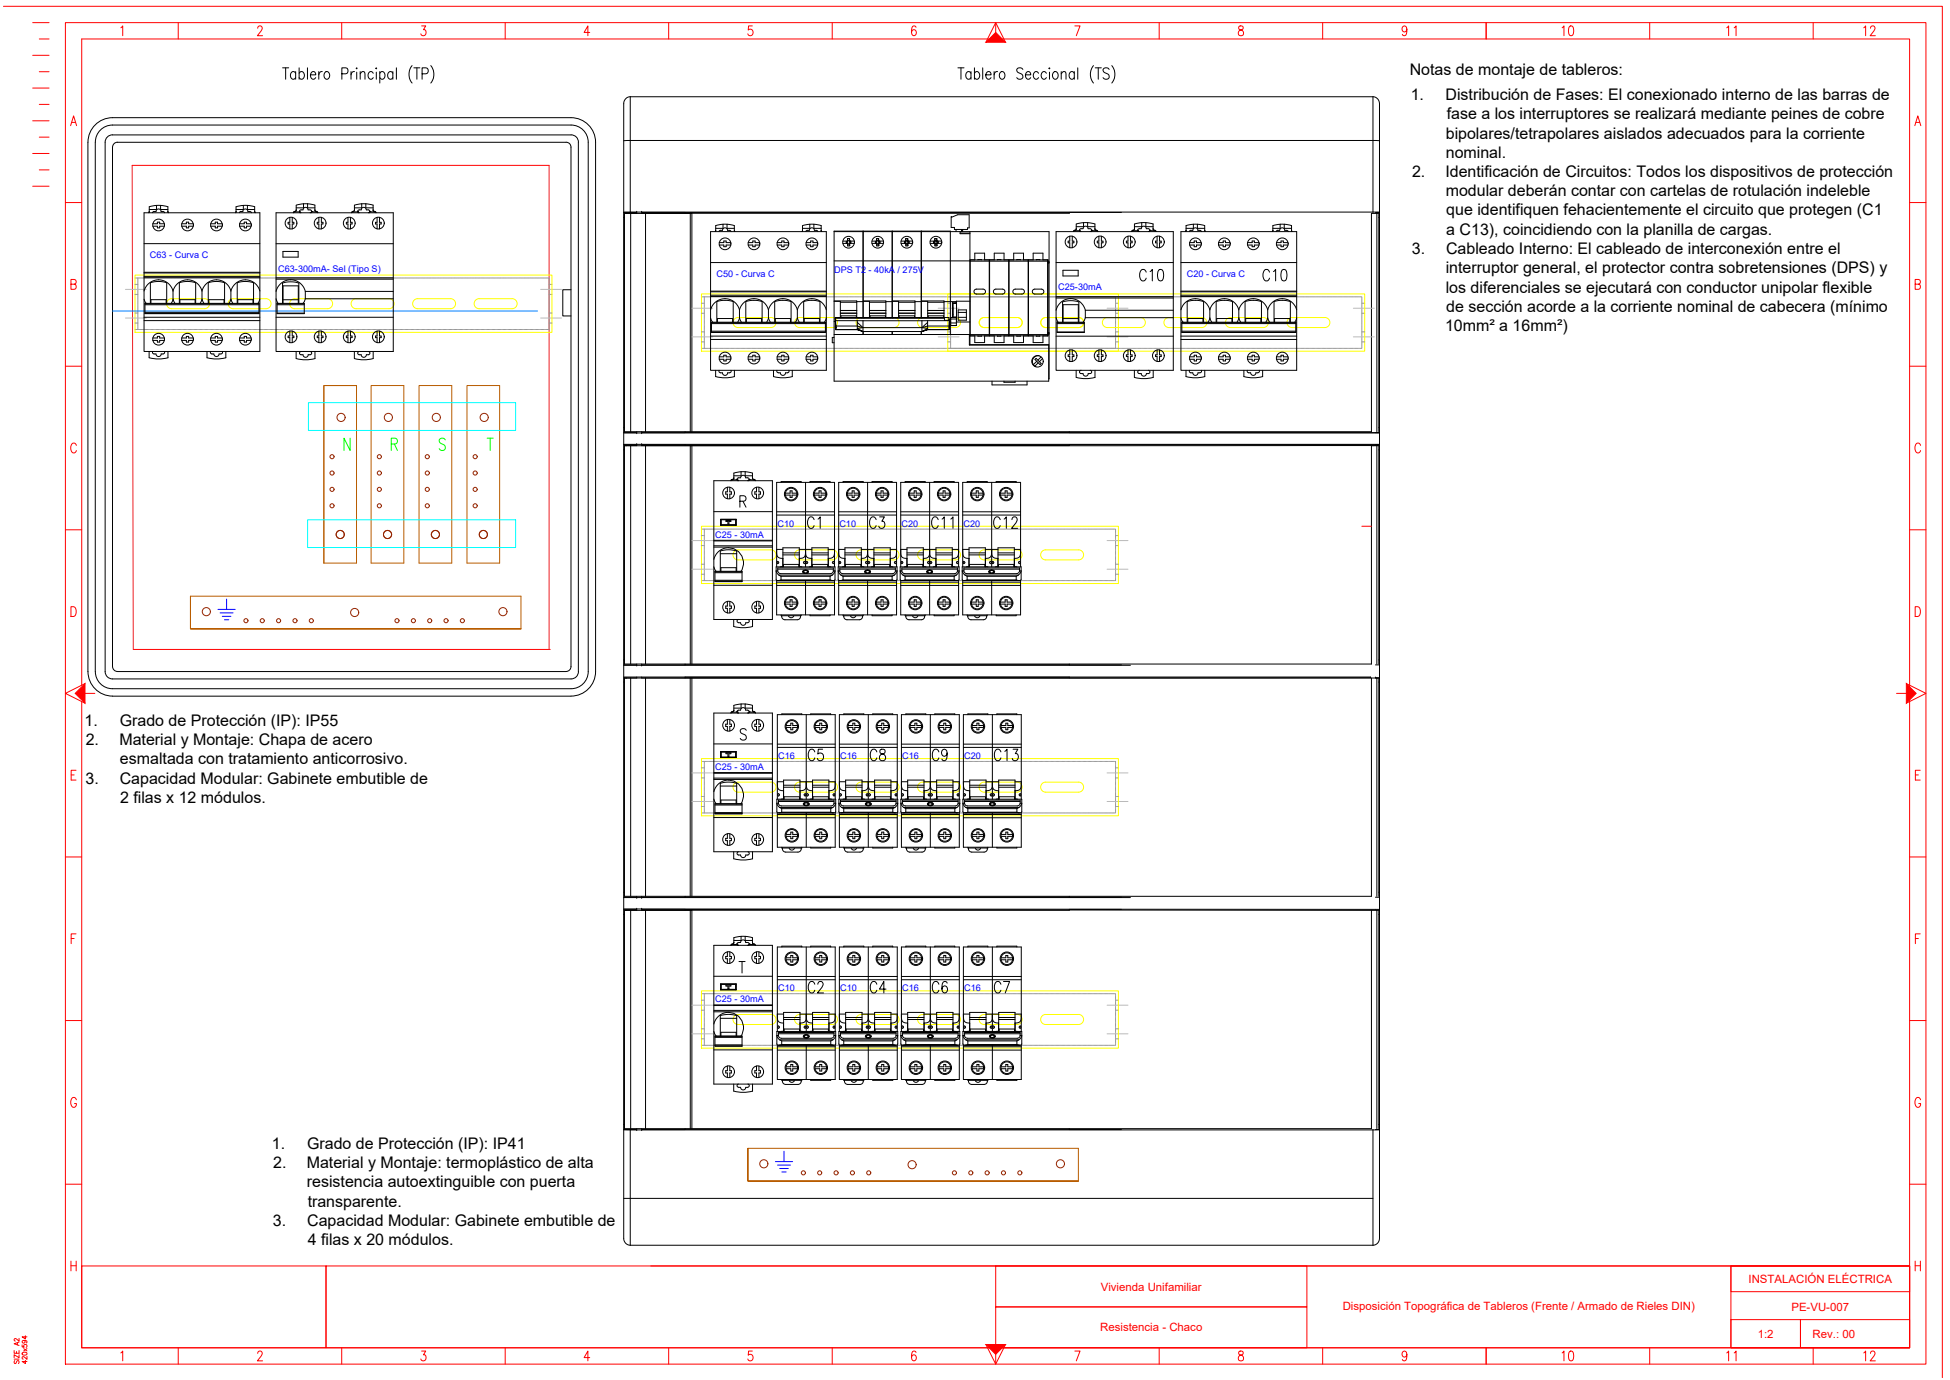
[picture p7: page 7]
DPS T2 - 40kA / 275V C50 - Curva C; C63 - Curva C; C63-300mA- Sel (Tipo S); C20 - Curva C

Notas de montaje de tableros:
1. Distribución de Fases: El conexionado interno de las barras de
fase a los interruptores se realizará mediante peines de cobre
bipolares/tetrapolares aislados adecuados para la corriente
nominal.
2. Identificación de Circuitos: Todos los dispositivos de protección
modular deberán contar con cartelas de rotulación indeleble
que identifiquen fehacientemente el circuito que protegen (C1
a C13), coincidiendo con la planilla de cargas.
3. Cableado Interno: El cableado de interconexión entre el
interruptor general, el protector contra sobretensiones (DPS) y
los diferenciales se ejecutará con conductor unipolar flexible
de sección acorde a la corriente nominal de cabecera (mínimo
10mm² a 16mm²)

1. Grado de Protección (IP): IP55
2. Material y Montaje: Chapa de acero
esmaltada con tratamiento anticorrosivo.
3. Capacidad Modular: Gabinete embutible de
2 filas x 12 módulos.

1. Grado de Protección (IP): IP41
2. Material y Montaje: termoplástico de alta
resistencia autoextinguible con puerta
transparente.
4 filas x 20 módulos.

Disposición Topográfica de Tableros (Frente / Armado de Rieles DIN)
