JosePaen/proyecto-electrico-vivienda-unifamiliar/(commit log)

2026-11-02 Update README.md
    Se agrega el Readme
2026-11-02 DWG y XSLX
    Agrega archivos fuente CAD y planillas de cálculo Excel
    [PE-VU_Proyecto_Electrico_Vivienda_Unifamiliar.dwg, PE-VU_Proyecto_Electrico_Vivienda_Unifamiliar.xlsx]
2026-11-02 PDF
    Agrega archivos de presentación PDF
2026-11-02 Update README.md
    Se corrige el Readme al agregar DWG y XLSX
2026-11-02 Delete PE-VU_Proyecto_Electrico_Vivienda_Unifamiliar.dwg
    Se borra para resubirse
    [PE-VU_Proyecto_Electrico_Vivienda_Unifamiliar.dwg]
2026-11-02 Delete PE-VU_Proyecto_Electrico_Vivienda_Unifamiliar.pdf
    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
2026-11-02 Delete PE-VU_Proyecto_Electrico_Vivienda_Unifamiliar.xlsx
    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
    [PE-VU_Proyecto_Electrico_Vivienda_Unifamiliar.xlsx]
2026-11-02 Update README.md
    Se reorganiza la información
